amFoco/Engineering-Portfolio/Baja/Drivetrain/DT - TOOL/DT - TOOL - Excel/DT - TOOL - E001 - Gear Calculator.xlsx

Sheet: Summary
Baja SAE Restricted Kohler CH440 |  |  |  |  |  |  |  | Requirements
Engine Speed (RPM) | 3600 | 3400 | 3200 | 3000 | 2800 | 2600 | 2400 | Max Speed | 34.76413 | mph | 50.98739067 | ft/sec
Torque Net Corrected (ft-lb) | 13.5 | 14.5 | 15.4 | 16.6 | 17.4 | 18.1 | 18.5 | Max Torque | 425.5178743 | lb-ft
Power Net Corrected (HP) | 9.3 | 9.4 | 9.4 | 9.5 | 9.3 | 9 | 8.5 | Max Acceleration | 0.5070351122 | g's | 16.32653061 | ft/sec
Inputs |  |  |  | Calculated |  |  |  | Vehicle Specs
Acceleration |  |  |  |  |  |  |  |  | Value | Units | Notes
 | Value | Units | Notes |  | Value | Units | Notes | Gross Weight | 578 | lbs
Distance | 100 | ft |  | Acceleration | 16.32653061 | ft/sec^2 |  | Front Weight Distribution | 0.4
Time | 3.5 | sec |  | Acceleration | 0.5070351122 | g's |  | Rear Weight Distribution | 0.6
Air Density | 0.00238 | slugs/ft^3 |  | Max Driving Force | 40.22140592 |  |  | Front Axle Weight | 231.2 | lbs
Frontal Surface Area | 14 | ft^2 | Place Holder, need estimate | Max Theoretical Power | 4702.5 | lb-ft/s |  | Rear Axle Weight | 346.8 | lbs
Coefficient of Drag | 1.08 |  |  | Max Power Available | 4389.00143 | lb-ft/s |  | CoF Tire-to-Asphalt | 0.788
Coefficient of Rolling Resistance | 0.068 |  |  | Max Power Available | 7.980002601 | hp |  | CoF Tire-to-Dirt | 1.183
Driveline Efficiency | 90% |  |  | Gear Reduction | 6.777659876
Realistic Efficiency | 95.09900499%
Inputs |  |  |  | Calculated
Sled Pull/Low Gear
Tire Size | 0.9166666667 | ft | Tr | Cable Tension | 536.0135111 | lbs | FC
Angle of Cable | 0.5235987756 | rad | theta | Torque | 425.5178743 | lb-ft | Tmax
Payload Weight | 1000 | lbs | WL | Minimum Driving Force | 227.732 | lbs | FD,min
Hitch Point Height on Sled | 4 | ft | LL | Maximum Driving Force | 341.887 | lbs | FD,max
Hitch Point Length to Axle | 11 | ft | LT | Max Theoretical Torque | 626.7928333 | lb-ft | Ttraction limited
Sled Weight | 1000 | lbs | WS | Gear Reduction | 33.88069369
Hitch Point Length to CG | 6 | ft | LS
Hitch Point Length to Support Plate | 2 | ft | LN
CoF Sled to Surface | 0.45 | ft | mue
Hitch Point Length to CG of Payload | 0.5 | ft | LF

Sheet: Breakdown
 | Low | High
Engine | 2400 | 3600 |  | 350 | 1270.588235 | 39.6 | 22
Sun | 3600 | -3600
Ring | 350 |  |  | 6.857142857 | 1.888888889
Counter | 3 | 3
Differentials | 3 | 3
Portal Hubs | 2 | 2
 |  |  | 30

Sheet: eCVT
Inputs
Gear | Pressure Angle | Teeth | Diametral Pitch | Pitch Diamter | Base Diamter | Outside Diameter | Center-Center | Contact Ratio | Face Width | RPM (Low) | RPM (High) | Carrier | 2200 | RPM
Sun |  | 91 |  |  |  |  |  |  |  | 3600 | -3600 |  | 3600 | RPM
Planet |  | 11 |  |  |  |  |  |  |  |  |  | Tire Radisu | 0.2794005588 | meters
Ring |  | 114 |  |  |  |  |  |  |  | 1082.45614 | 6829.824561
Pinion |  | 19 |  |  |  |  |  |  |  | 1082.45614 | 6829.824561
Counter |  | 55 |  |  |  |  |  |  |  | 373.9393939 | 2359.393939 | Required |  | Theoretical
Bevel Pinion |  | 14 |  |  |  |  |  |  |  | 373.9393939 | 2359.393939 | 34.76413 | mph | 36.89053808 | mph | 33.20148427
Bevel Counter |  | 43 |  |  |  |  |  |  |  | 121.7477097 | 768.174771 | 425.5178743 | lb-ft | 500.020756 | lb-ft | 450.0186804
Hub Pinion |  | 11 |  |  |  |  |  |  |  | 121.7477097 | 768.174771
Hub Counter |  | 15 |  |  |  |  |  |  |  | 89.28165375 | 563.3281654
