amFoco/Engineering-Portfolio/Baja/Drivetrain/DT - TOOL/DT - TOOL - Excel/DT - TOOL - E002 - Decisions.xlsx

System
 | Cost | Complexity | Reliability | Weight | Packaging | Total
AWD | 4 | 4 | 3 | 5 | 3 | 19
4WD Gears | 3 | 3 | 2 | 3 | 2 | 13
4WD Chain | 2 | 2 | 3 | 2 | 5 | 14
Selectable 4WD | 3 | 4 | 3 | 4 | 3 | 17
Transmission
 | Cost | Complexity | Reliability | Weight | Packaging | Adjustability | Creativity | Total
eCVT | 5 | 4 | 3 | 3 | 4 | 1 | 1 | 21
CVT | 4 | 1 | 3 | 2 | 3 | 5 | 5 | 23
