amFoco/Engineering-Portfolio/Baja/Drivetrain/DT - V1/DT - V1 - REF001 - Simplified Completed System.pdf

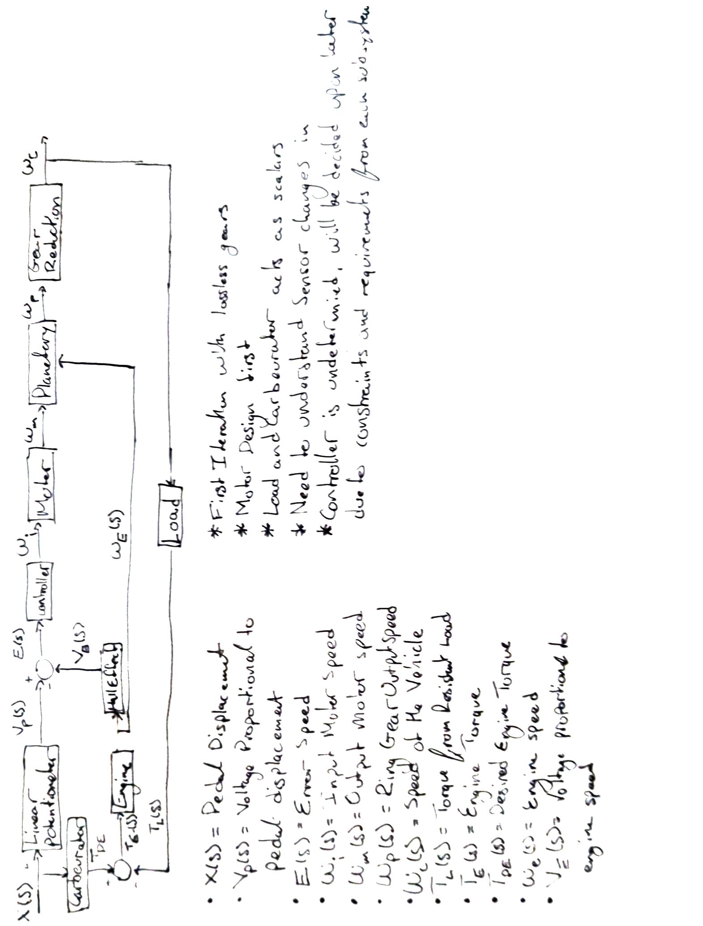
[picture p1: page 1]
