amFoco/Engineering-Portfolio/Baja/Brakes/BR - TOOL/BR - TOOL - Excel/BR - TOOL - E001 - Brakes Calculator.xlsx

Sheet: Sheet1
Inputs |  |  |  | Requirements
Term | Value | Units | Notes | Term | Value | Units | Notes
Gross Vehicle Weight | 578 | lbs | W | Front Axle Weight | 231.2 | lbs | W1 Static
Front Weight Distribution | 0.4 |  |  | Rear Axle Weight | 346.8 | lbs | W2 Static
CG Height | 1.666666667 | ft | h | Velocity | 36.66666667 | ft/sec | V
Wheelbase | 5 | ft | l | Deceleration | 1.391764435 | g's | a/g
Tire Radius | 0.9166666667 | ft | rtire | Normal Force on Front Axle | 499.3466145 | lbs | Fz,f
Driver Force | 70 | lbs | Fdriver | Normal Force on Rear Axle | 78.65338548 | lbs | Fz,r
Tire-to-Surface CoF | 0.75 |  | utire | Front Torque Requirement | 343.3007975
Pad-to-Rotor CoF | 0.35 |  | upad | Rear Torque Requirement | 54.07420252
Velocity | 25 | mph | V
Stopping Distance | 15 | ft | dx

Sheet: Hardware
Calipers |  |  |  |  |  |  |  |  | Master Cylinder
Caliper | Pistons | Piston Type | Diameter | Piston Area | Total Area | Pad Volume | Price | Brand | Master Cylinder | Bore | Area | Price | Brand
GP200 | 2 | Stainless | 1.25 | 1.23 | 2.46 | 0.34 | $128.64 | Wilwood | 78-Series | 0.8125 | 0.5184855063 | $275.00 | Tilton
Dynalite Single Floater | 1 | Stainless | 1.75 | 2.4 | 2.4 | 1.1 | $148.63 | Wilwood | 78-Series | 0.9375 | 0.6902913545 | $275.00 | Tilton
Dynapro Single | 2 | Stainless | 1.38 | 1.5 | 3 | 1.1 | $148.92 | Wilwood | 78-Series | 0.75 | 0.4417864669 | $275.00 | Tilton
 |  |  |  |  |  |  |  |  | 78-Series | 0.625 | 0.3067961576 | $275.00 | Tilton
 |  |  |  |  |  |  | $395.82 |  | 78-Series | 0.7 | 0.3848451001 | $275.00 | Tilton
 |  |  |  |  |  |  |  |  | 78-Series | 0.875 | 0.6013204689 | $275.00 | Tilton
 |  |  |  |  |  |  |  |  | 78-Series | 1 | 0.7853981634 | $275.00 | Tilton
 |  |  |  |  |  |  |  |  | Kart Master Cylinder (RM1) | 1/2 | 0.18 | $41.50 | Wilwood
