amFoco/Engineering-Portfolio/Baja/Drivetrain/DT - TOOL/DT - TOOL - SolidWorks/DT - TOOL - S001 - External Spur Gear.SLDPRT

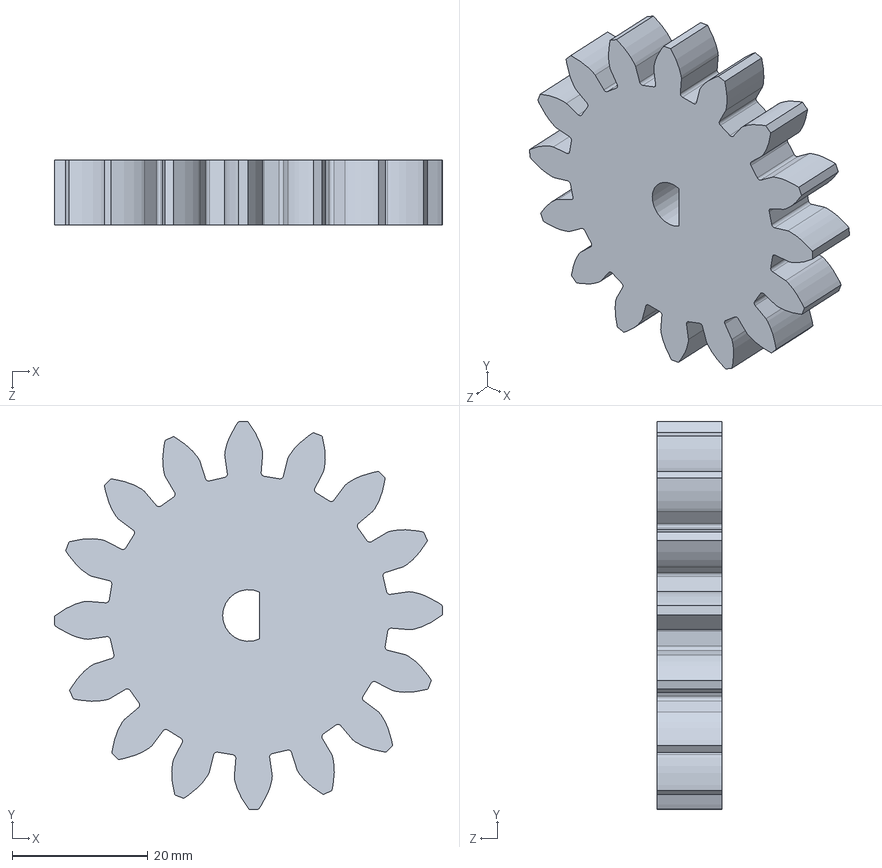
[picture p2: CAD file, 2023-02-24]
Baja/Drivetrain/DT - TOOL/DT - TOOL - SolidWorks/DT - TOOL - S001 - External Spur Gear.SLDPRT
57.1 x 57.1 x 9.53 mm
