amFoco/Engineering-Portfolio/(list of files, cad)

Other CAD files:
Baja/Ergonomics/ER - V1/ER - V1 - AFT/ER - V1 - AFT - REF001 - Driver Positioning.SLDPRT
Baja/Suspension/SS - V1 - FORE - REF002 - Steering Geometry.SLDPRT
Baja/Suspension/SS - V1 - FORE - REF001 - Front Geometry.SLDPRT
Baja/Suspension/SS - V1 - AFT - REF002 - Rear Suspension Geometry.SLDPRT
