amFoco/Engineering-Portfolio/(commit log)

2023-01-30 Suspension - Ride/Roll/Spring Rates
2023-02-23 Create Brakes
2023-02-23 Add files via upload
    Need to improve the final selection, as of now it just spits out two matrices for the front and rear breaking torques (rows are pedal ratio and the columns are the bore for the master cylinder). The user compares each matrix to its corresponding required braking torque * 1.2 (increase by 20% for error margin due to large estimates of vehicle weight and CG) to find the best pedal ratio and master cylinders for the front and rear braking systems.
2023-02-24 Add files via upload
    Simplified block diagram for the drivetrain subsystem
2023-02-24 Add files via upload
    Current version of the Design Notebook. This isn't a technical document, but rather what I am thinking and doing throughout the project.
2025-10-01 Update and rename BrakeCalculator.m to Baja/Brakes/BR - TOOL/BrakeCalculator.m
2025-10-01 Update and rename Baja/Brakes/BR - TOOL/BrakeCalculator.m to Baja/Brakes/BR - TOOL/BR - TOOL - MatLab/BrakeCalculator.m
